Cosimo2233/FPGA-puzzle/report/大模型协作记录.md

# 大模型协作记录

本项目使用 Codex 辅助工程整理、接口检查、测试结果分析及技术文档编写。硬件接线、机械标定和实际运行效果由团队现场确认，模型建议结合源码、工具输出和实测结果决定是否采用。

## 协助内容与采纳情况

| 协助内容 | 处理结果 |
|---|---|
| 按比赛目录整理源码、构建脚本和验证资料 | 已采纳。移除无关旧板文件和编译中间文件，保留保存的 BD、约束、依赖和重建入口。 |
| 检查新增计时功能是否完整迁入交付工程 | 已采纳。核对计算时间、总时间、取消和失败状态，并检查源码与软件包一致性。 |
| 梳理 PS/PL 分工并绘制总体框图 | 已采纳。明确 PS 负责识别、规划与调度，PL 加速部分计算；七巧板求解保留在 CPU。 |
| 将技能入口改成小写 `skill.md` | 未采纳。保留两个技能各自的子目录及原有 `SKILL.md` 入口。 |
| 宣传文案先介绍系统组成和技术实现 | 未沿用。根据教师反馈，调整为先说明拼图功能，再介绍硬件加速。 |

## 交互与纠错示例

整理技能目录时，模型最初建议将入口改为小写。团队回复：“不用这样，可以直接放子文件夹。”随后保留了两个独立技能目录，修正了原方案。框图初版只标注 XCZU5EV，核对器件信息后补全为 XCZU5EV-2SFVC784I。

验证时同时保留通过结果与已知问题。主机适用测试通过 607 项，但存在平台排除项和历史失败；没有将这一结果写成全量测试通过。详细范围见 `../build/reports/current/validation_summary.md`。

## 技能提炼与记录补充

协作经验整理在 `../skill/`：FPGA 技能强调依赖追踪、构建阶段和板级验证的区分；Python 技能强调固定依赖、公共接口和回归验证。现有工程检查可作为使用记录，跨板卡、跨项目的复用效果仍需进一步验证。

本文为协作摘要。按比赛指南，提交前还需附上关键开发环节的原始提示词、模型回答、纠错过程及对应验证结果，并补充使用日期和模型版本；尚未完整归档的原始记录不以事后总结代替。
