Cosimo2233/FPGA-puzzle/board/results/historical/tangram-20261027/readme.md

# 七巧板功能与板端验证（2026-10-27）

已实现并部署正方形、猫、兔、鱼、船、房子六个图案。按用户补充要求，默认改为单张新照片：识别完成即关闭相机，使用冻结照片计算和显示；失败直接提示，不循环重拍。多帧审查仅为可选调试设置。

## 验证结果

- 主机适用单元测试：528 项及 130 个子测试通过。Windows 的符号链接权限、fcntl/设备路径相关测试文件未纳入此通过数；另排除已有固定配置断言（期待 20 mm，实际配置为 8 mm）。完整单元测试不宣称全部通过。
- 独立求解器七巧板测试：21 项通过，包括六个精确模板、同形片互换、镜像限制、无缩放刚体变换、目标区不足，以及六图案的现场实拍轮廓回归。
- 板端安装：应用和求解器 wheel 经哈希核对安装，原机械配置及固定/随机运动权限未变。正式发布位于 `/opt/ec26e/releases/tangram-20261027-r3`，完整功能前回滚快照位于 r2 的 `production-before`。
- 板端单张实拍：一张照片供六图案共用，全部得到完整七步方案，通过实测目标间隙和机械头限位检查。每个结果的 `motion_executed=false`，不将单帧检查标为多帧稳定验收。
- HDMI 菜单：七巧板选择、图案下拉框、取料/目标区、七片源轮廓和落点、旋转角及本次快照显示通过。使用强制仅规划的测试菜单验证启动与任务进程切换，结果为 ready。

| 图案 | 板端耗时（秒） | 计时范围 |
| --- | ---: | --- |
| 正方形 | 7.213 | 首张相机启动、采图、识别、规划、显示 |
| 猫 | 1.514 | 复用同一张照片的已识别轮廓，几何规划 |
| 兔 | 1.527 | 同上 |
| 鱼 | 1.357 | 同上 |
| 船 | 1.526 | 同上 |
| 房子 | 4.682 | 同上 |

详细方案见 [live-results.json](live-results.json)，菜单任务结果见 [gui-result.json](gui-result.json)，界面实拍见 [menu-prediction.png](menu-prediction.png)。完整原始采图和中间记录保留在板端 `/opt/ec26e/validation/tangram-20261027`。

## 识别与几何处理

原有色差梯度细化在白片投影阴影附近会跳选边缘，实拍中约每数帧出现一次 3 mm 顶点跳变。七巧板改用掩膜轮廓的整条边鲁棒拟合，现场观测的多数顶点波动降至约 0.2–0.7 mm；原纸片分支保持原方法。

现场七片与理想 100 mm 模板存在轮廓差异，最大顶点拟合残差约 2.64 mm。片型识别使用 3 mm 容差，搬运目标仍为原实测多边形的纯旋转和平移。规划在限定位移内调整目标，实测轮廓之间保留至少 1 mm 间隙；没有缩放碎片，也没有用反射矩阵模拟翻面。

## 实物验收边界

现场已确认本功能沿用原程序的运动方式和标定，`actuation_overrides={}`，直接引用板端已验收配置。只规划验证完成后，M0 状态为 version=1、armed=false、magnet=false、fault=0，随后按计划执行了一片的大三角搬运试验：先校验完整七片方案，再单独测试第一片，测试未修改生产菜单的运动开关。

控制日志记录了 XYZ 使能、Z 抬升、顺时针旋转约 94.8°、返回起点、旋转回零、磁铁关闭和失能，执行器正常退出。但动作后单张照片仍检出七片都在右侧，左侧目标区为空。因此单片实物验收失败，已停止后续整图动作；旋转反馈和桥接 ACK 不能证明 XYZ 实际运动或磁铁吸取成功。没有将最近的其他源碎片误记为目标精度测量结果。

证据见 [单片结果](first-piece-result.json)、[测试使用的完整方案](first-piece-plan.json) 和 [动作后照片](first-piece-after.png)。七片前后质心的最小距离整体匹配中，最大变化仅 0.231 mm，支持“源区没有完成搬运”的判定。M0 再次查询仍为未使能、磁铁关闭、fault=0。需根据现场观察区分 XY/Z 未动作、未吸起或其他机械问题；新模式继续 `motion_verified=false`，不自动重试运动。六图案各三次搬运及 2 mm / 3° 精度尚未验收。

XPR、BD、bitstream、设备树和启动镜像未随本功能更新；板卡未重启。SSH 使用 A7A 网口跳板，主机 RSA 公钥通过直连串口核对；root 家目录属主修正及公钥接入记录见 [操作说明](../../tangram.md)。
