Cosimo2233/FPGA-puzzle/build/reports/current/validation_summary.md

# 2026 年 11 月 1 日验证报告

测试环境为 Windows 主机和独立 Poetry 环境。应用从仓库源码加载，求解器与桥接客户端从固定 wheel 安装。

| 检查 | 结果与范围 |
|---|---|
| 主机适用单元与集成测试 | 607 项、139 个子测试通过；排除 4 个平台不适用文件和 3 条已知失败 |
| 运行计时 | 147 项、34 个子测试通过，覆盖计算与运动分界、冻结显示、重启计时、取消及失败 |
| HDMI RTL | 两个测试平台通过，覆盖颜色顺序、时钟、扫描、消隐和断流恢复 |
| HLS C 仿真 | preprocess、rigid、clearance、candidate 四核通过 |
| M0 协议 | 两个原生 C 测试通过，覆盖协议、租期和串口故障处理 |
| Vivado 工程 | BD、四核 ABI 和 921 个引用文件检查通过 |
| 软件打包 | wheel 元数据无本机 file: 依赖，计时模块已包含在应用包中 |
| 参考硬件恢复 | XSA 内 bit/HWH 与参考清单一致，Bootgen 输出校验通过 |
| 中文字体 | 当前界面与图案名称所需字形覆盖检查通过 |

## 已知失败与平台要求

完整单元测试中有 20 个失败，集成测试中有 2 个失败。对照结果见 `baseline_comparison.json`。19 个单元失败与 Windows 的符号链接权限、fcntl 或设备路径有关；其余 1 个单元和 2 个集成失败涉及历史配置或布局断言。

默认主机入口通过 `sim/host_profile.json` 指定排除项；`sim/run_tests.ps1 -Full -All` 运行完整测试集合，原断言保留。

## 硬件与实物验证范围

工程检查使用与参考源码一致的既有 HLS IP，并对四核源码重新执行 C 仿真。该记录不包含新的 HLS 综合或 Vivado 布局布线；完整实现的资源与时序见 `build/reports/reference/`。首次构建需先恢复 HLS IP。

计时测试使用受控时钟和假执行器。HDMI 仅规划显示的实测记录位于 `board/results/historical/task-timing-20261101/`。仅规划时间截至规划完成，不作为实物拼装耗时。
