Cosimo2233/FPGA-puzzle/board/results/historical/axu5ev-20261021/readme.md

# 2026-10-21 远程管理、视觉修正与菜单自启

> 后续标定核对更正：此前“沿用旧标定”的记录不完整。新板遗漏 active 机械参数，实际采用代码默认 A4 原点 (14.5, 6.5) mm，而旧板 active 为 (18.5, -8) mm。用户反馈运动完成但精度不足后查明，按用户明确要求已恢复旧 active 全套机械参数（包括 Y 下限 0 mm），保留新视觉参考四角和 M0 接线。固定/随机配置实际解析均通过，只读取配置，没有运动。备份及全部参数见 `calibration-restored.json`；这不是新装置的物理复标验收。

## 视觉

先前固定四片运动测试在 120 秒识别阶段超时，退出码 75，未进入执行器；原记录保存为 `previous-fixed4-run.json`、`previous-fixed4-task.log`。不重放旧运动测试。

本轮通过 A7A 双跳 SSH 获取 20 张真实 1280×720 摄像头图像。旧参考四角与当前工作区位置不符；粗边线回退路径在找不到右边界时直接采用旧参考边，右侧坐标范围在这批图像中达到 108.01 px，切断右侧拼片，造成错误的边界接触报告。旧流程 15/20 帧输出四片，所有帧均使用未经完整校验的回退区域。

更新新板 fixed/random profile 的参考四角后，20/20 帧输出四片，四角单坐标最大范围降至 1.20 px。回退线只作为重新搜索的种子，必须通过实际边缘支持、几何范围和纸色校验；缺失、严重遮挡或错误参考区域明确报定位失败，不再假定参考边有效。不放宽片数、轮廓质量、边界或稳定审查阈值。

原始图像位于主机 `build/axu5ev/vision-20261021/` 和板端 `/opt/ec26e/validation/vision-20261021/`；两帧保存为单元测试 fixture。`vision-capture.json` 为原结果，`vision-replay.json` 为同帧对比。

部署新 wheel 后，在板上运行仅规划 `plan-live`：处理 36 帧后通过完整稳定审查，固定四片求解成功，confidence=0.805，求解约 3.001 秒。输出 `live-plan.json`，日志 `live-plan.log`。没有打开执行器、没有运动。本结果不重新验收机械尺度/手眼标定，也不代表所有光照、摆放场景均通过。

主机相关检查：55 项测试与 11 个子测试通过，涵盖工作区、现场图像、传统轮廓、稳定审查、任务调度、预览和 U-Boot 脚本。wheel 构建、板端安装与 pip check 通过。

## 自启部署

工程启动入口、恢复开关、SysV 服务和监督程序已安装。厂家平台拒绝加载 PL 的保护已在实机验证；U-Boot 脚本 CRC、原脚本保留和恢复入口已通过主机测试。SHA-256 及备份位置见 `deployment.json`。

实际冷启动已自动进入工程系统，PL/HDMI 加载成功，中文菜单自动启动，USB 摄像头和 M0 别名均恢复。首次启动发现网络漏项：厂家网络脚本只 auto eth1，而工程设备树停用厂家 PL 后 PS 网口变为 eth0，导致 SSH 不通。经 A7A 调试串口执行 ifup eth0 恢复，并在自启程序中加入按 ff0e0000.ethernet 控制器身份选择网口的逻辑。

修正后通过串口停止菜单服务、ifdown eth0、重新启动服务，实测服务自行取得保留地址 10.42.0.47，SSH、Xorg 和菜单恢复，不重载已正常运行的 PL。网口选择新增单元测试通过（3 个自启相关测试、3 个子测试）；尚未对最终网口修正版做第二次整板冷启动，记录中明确保留此边界。

现场确认“菜单和四片预览都正常”。最终状态见 `final-status.json`：菜单仅规划、运动关闭，预览已处理 127 帧，最后一帧恰好四片且轮廓合格。此计数仅表示已处理帧数，不能解释为所有 127 帧均通过。`autostart-supervisor.log` 保留初次冷启动和修正后服务启动过程；`deployment-initial.json` 保留初始部署身份，`deployment.json` 记录最终脚本 SHA 和验证范围。

板卡时钟本轮显示 2026-10-20，而用户侧日期为 2026-10-21；保留原日志时间，不把设备时钟差异当作另一轮测试。

## ?????????????

?????????????????? 5 ????? 33 ??????????? 24.079 ??????? 0.8045067??????? 4 ??????motion_executed=false???? user-fixed4-plan.json?user-fixed4-menu.log?

???????????????????????? AXU5EV ?????? M0 ??????????????????/???????M0 ?????????????????????????????A4 ?????????????????????????

?????? motion_enabled=true?plan_only=false?????? busy=false?events=[]???????????? ARM????????????????????????????????????????????????????????

64 ?????? 20 ????????????????????????????M0 ???????????? wheel ??? pip check ?????????????????? motion-enable-deployment.json?????? motion-enabled-menu.json?
