Cosimo2233/FPGA-puzzle/board/results/historical/tangram-layout-audit-20261029/readme.md

# 七巧板名称与逐片拼法审查（2026-10-29）

用户要求核对名称和拼法，并明确船采用本轮指定的紫色帆船（与原第四张参考图左上角相同）。逐图审查发现：菜单的名称和 pattern_id 没有串位，但旧模板的猫、兔、鱼、船、房子、鸟、海豹与选定参考图存在布局差异。此前面积、片型和无重叠测试不足以证明图案正确，这部分验证遗漏已经补上。

## 逐项结果

参考图编号按用户最初上传的四张图排序；同名图案有多种拼法，以下明确本实现所选版本。

| 名称 / ID | 核对依据 | 结果与处理 |
| --- | --- | --- |
| 正方形 / square | 七片组成 100×100 mm 正方形 | 正确，保持 |
| 猫 / cat | 第二张图第三行第二列 Cat | 修正头部与颈部的连接位置、耳部位置和尾巴的平行四边形方向 |
| 兔 / rabbit | 第二张图第四行第四列 Rabbit | 重建上下两大三角、下方中三角和小三角、头部及耳朵；旧版把身体拼成了另一种方块结构 |
| 鱼 / fish | 第二张图第二行第五列 Fish | 修正两片大三角形成的左侧鱼身、中间鱼鳍及右侧方形尾巴的位置 |
| 船 / boat | 用户本轮明确指定的紫色 boat | 重建两片主帆、左侧小帆和方片、下方平行四边形与中三角船身；保留参考图左帆下方白缝 |
| 房子 / house | 第四张图第二行第三列 house | 方片移到烟囱，重建屋顶、右侧斜顶与墙体分片；旧版无烟囱且大片分配不符 |
| 狗 / dog | 第一张图第一行第二列 dog | 名称与主体拼法正确，仅小幅对齐尾巴位置 |
| 天鹅 / swan | 第二张图第三行第一列 Swan | 正确，保持 |
| 鸟 / bird | 第二张图第二行第四列 Bird | 修正头部方片沿身体边连接的位置、嘴及下方中三角位置 |
| 企鹅 / penguin | 第二张图第二行第二列 Penguin | 正确，保持 |
| 海豹 / seal | 第二张图第三行第三列 Seal | 头部方片改为参考图约 30° 的摆角，保持身体和鳍的片型 |
| 椅子 / chair | 第四张图第二行第二列 chair | 正确，保持 |

[修正后的十二图案](patterns.svg) · [用户指定船的重建图](boat.png)

整体旋转及允许的整图镜像仍可能改变实物预览朝向，镜像会在菜单标注；这不改变图案名称。此处按参考图的直立朝向核对标准布局。

## 独立参考依据和测试

独立求解器新增 `tests/fixtures/tangram-reference-layouts.json`，保存从用户参考图独立采样的七片像素顶点和图案出处；这些像素绝不用于运动坐标。`tests/test_tangram_reference_layouts.py` 对每个标准模板只拟合一个整体显示尺度和平移，再逐片比较边界，允许同形三角互换，不允许各片任意移动来迎合参考图。名称的中文映射另有独立断言。

截图本身有描边、压缩、轻微拉伸和人工采点误差，参考比较门槛为图案长边的 5%，仅用于捕获拼法和身份错误；不能当作毫米定位精度。修正后十一项截图比较的最大边界偏差约为参考图长边的 0.6%–3.3%，正方形另由精确几何测试覆盖。详见 [修正前后比较](reference-checks.json)。将同一检查运行于改动前 `5b16154` 的求解器，猫、兔、鱼、船、房子、鸟、海豹七项失败；修正后全部通过。

通过 Poetry 运行：

```powershell
# D:/FPGA/puzzle-solver
poetry run pytest tests/test_tangram.py tests/test_tangram_reference_layouts.py -q
# D:/FPGA/puzzle5ev/sw
poetry run pytest tests/unit/test_tangram.py tests/unit/test_board_menu.py tests/unit/test_menu_model.py -q
```

求解器 **75 项通过**，应用相关测试 **68 项通过**。标准片尺寸、七片完整、无重叠、镜像限制、实测刚体搬运和 1 mm 间隙仍通过。为让参考图中约 30° 方形头部的海豹在现有工作区放下，全部 45°、15° 朝向无解时，再尝试每 5° 的整图朝向；没有缩放片形或放宽机械限位。

## 部署与边界

发布目录 `/opt/ec26e/releases/tangram-layout-audit-20261029`。通过原 A7A 跳板更新求解器 wheel，复用当前应用 wheel；使用 `--preserve-profile`，保留全部机械配置及手动试机权限，见 [部署哈希](deployed.json)。板端复用上一轮单张实拍的七片轮廓验证十二图案，全部得到有效七步方案并通过机械软件限位，见 [复算结果](replay-results.json)。没有重新拍照或发送运动指令。

本次不修改视觉算法、运动执行器、XPR、BD、bitstream、设备树或启动镜像，不声称已完成实物拼装精度验收。恢复本次更正前的软件可使用此发布目录的安装器 `--apply --rollback`，从对应 `production-before` 恢复。
