Cosimo2233/FPGA-puzzle/board/results/historical/rotation-tolerance-20261030.md

# 启动前 1°、任务内后续吸取前 2°（2026-10-30）

用户报告连续两次拼兔子中途停止。当前启动日志 `menu-c5c159a7-4af2-494b-9e79-6511dbe4d8f7.log` 显示，两次分别在第五片、第四片搬运指令完成后，于下一片吸取前报错：目标 0°、反馈 358.7°、误差 1.3°。两次都已通过视觉、七片规划及软件限位，底层回零位置等待通过；应用的逐片 1° 复核使任务退出。故障时下一片尚未下降或通磁吸取。

此前取消了搬运中的额外 1° 复核，但把“运动前保留”实现为每片吸取前仍按 1° 检查，没有覆盖用户希望整次任务持续完成的情况。本次按用户最新明确要求修正共享执行器 `sw/src/ec_26_e/tasks/task1/actuation.py`：

- 启动回零及第一片吸取前，容差仍为 1°。
- 第一片放置后，后续各片吸取前的零位容差为 2°，恰好 2° 允许继续。
- 仍用单圈最短角差计算，358.7° 对零位的误差为 1.3°，不再导致上述中止。
- 不增加携带碎片期间的角度复核；底层多圈位置等待、通信/协议故障、超时、取消及异常清理保持。
- 运行中零位超过 2° 或反馈为 NaN 等无效值时，仍会在下一片吸取前拒绝；不承诺发生任意故障也绝不停机。

`_require_rotation_angle` 默认容差为 1°，后续周期通过 `pick_positioned=True` 显式使用 2°，第一周期不放宽。这是共享运动执行器的规则，固定、随机和七巧板模式共用；未修改原机械标定、图案、视觉或桥接协议。

## 验证

```powershell
# D:/FPGA/puzzle5ev/sw
poetry run pytest tests/unit/tasks/test_task1_actuation.py tests/unit/test_tangram.py -q
poetry build
```

84 项测试、34 个子测试通过，wheel 构建成功。新增现场 358.7° 复现、运行中 ±2° 边界继续完成两片、±2.1°/NaN 在下一片吸取前拒绝；启动前 1.1°、1.3°、2° 等仍拒绝。原搬运中角差、最终回零、超时及取消测试保留。

发布目录 `/opt/ec26e/releases/rotation-tolerance-20261030`，经 A7A 跳板使用原安装器 `--apply --preserve-profile` 更新，保留全套生产配置和手动试机权限。对应 `production-before` 可用同目录安装器 `--apply --rollback` 恢复。本次只部署及核验，不发送运动指令，不作实物精度验收；未修改 XPR、BD、bitstream、设备树或启动镜像。

部署后读取板端已安装源码，确认默认 1°、后续周期显式传入 2°；菜单已重新启动并空闲。发布哈希与保留配置哈希见 [部署记录](rotation-tolerance-20261030-deployed.json)。
