Cosimo2233/FPGA-puzzle/board/results/historical/task-timing-20261101/timing-replay.png

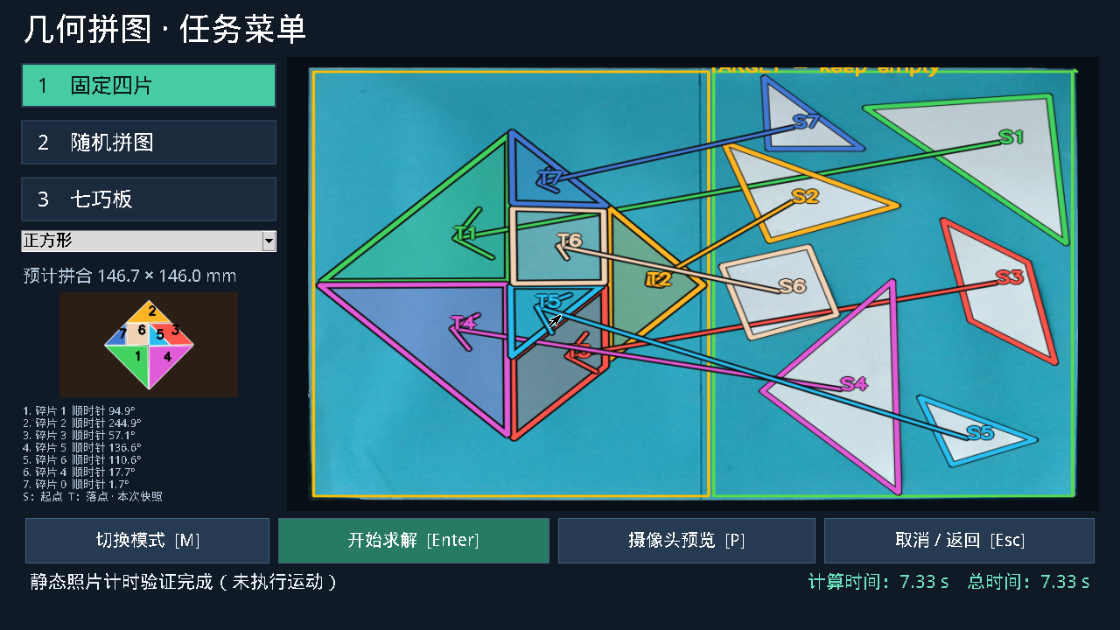
board/results/historical/task-timing-20261101/timing-replay.png
